Aliceyutzfly/ProjectX_selfbalancing_2627/Hardware/ProjectX_SelfBalance_PCB/ProjectX_SelfBalance.kicad_pcb

## KiCad design hardware/1151-boards/1151-boards.kicad_sch

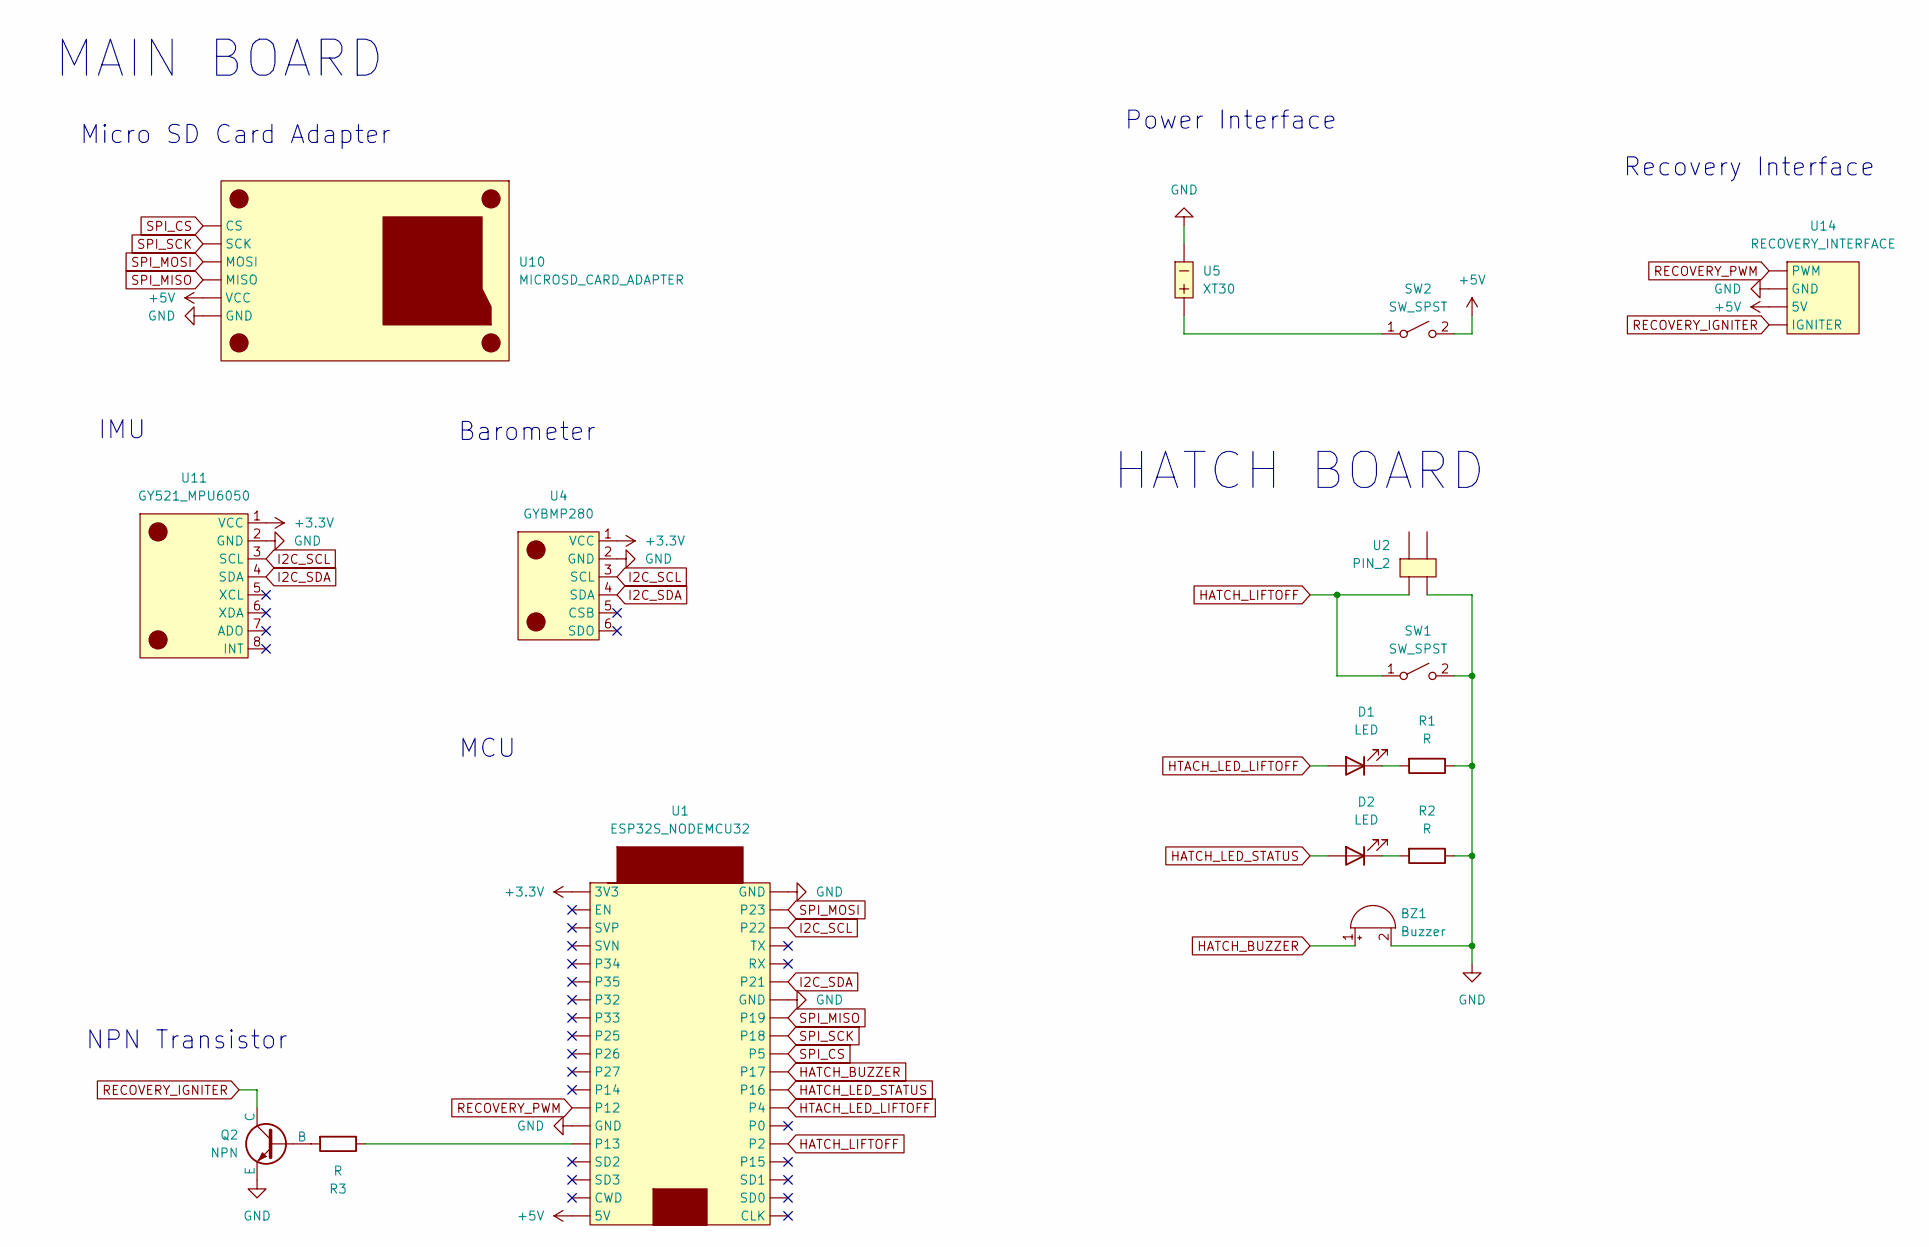
[picture p1: schematic 1151-boards.kicad_sch]

Parts:
BZ1: Buzzer
D1, D2: LED
Q2: NPN
R1, R2, R3: R
SW1, SW2: SW_SPST
U1: ESP32S_NODEMCU32
U2: PIN_2
U4: GYBMP280
U5: XT30
U10: MICROSD_CARD_ADAPTER
U11: GY521_MPU6050
U14: RECOVERY_INTERFACE

Connections:
+3.3V: U1.1 (3V3), U4.1 (VCC), U11.1 (VCC)
+5V: SW2.2 (B), U1.19 (5V), U10., U14.
GND: BZ1.2 (-), Q2.3 (E), R1.1, R2.1, SW1.2 (B), U1.14 (GND), U1.20 (GND), U1.26 (GND), U2., U4.2 (GND), U5., U10., U11.2 (GND), U14.
HATCH_BUZZER: BZ1.1 (+), U1.30 (P17)
HATCH_LED_STATUS: D2.2 (A), U1.31 (P16)
HATCH_LIFTOFF: SW1.1 (A), U1.34 (P2), U2.
HTACH_LED_LIFTOFF: D1.2 (A), U1.32 (P4)
I2C_SCL: U1.22, U4.3 (SCL), U11.3 (SCL)
I2C_SDA: U1.25 (P21), U4.4 (SDA), U11.4 (SDA)
unnamed: D1.1 (K), R1.2
unnamed: D2.1 (K), R2.2
unnamed: Q2.2 (B), R3.2
unnamed: R3.1, U1.15 (P13)
unnamed: SW2.1 (A), U5.
RECOVERY_IGNITER: Q2.1 (C), U14.
RECOVERY_PWM: U1.13 (P12), U14.
SPI_CS: U1.29 (P5), U10.
SPI_MISO: U1.27 (P19), U10.
SPI_MOSI: U1.21 (P23), U10.
SPI_SCK: U1.28 (P18), U10.

Notes on the sheet:
Barometer
Micro SD Card Adapter
Power Interface
MAIN BOARD
NPN Transistor
Recovery Interface
HATCH BOARD
IMU
MCU
