Aliceyutzfly/ProjectX_selfbalancing_2627/Hardware/ProjectX_SelfBalance_PCB/ProjectX_SelfBalance.kicad_pcb

## KiCad design hardware/example/example.kicad_sch

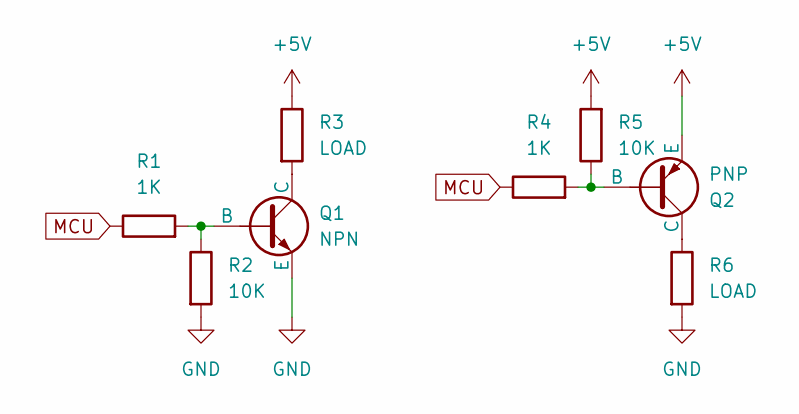
[picture p2: schematic example.kicad_sch]

Parts:
Q1: NPN
Q2: PNP
R1, R4: 1K
R2, R5: 10K
R3, R6: LOAD

Connections:
+5V: Q2.3 (E), R3.1, R5.2
GND: Q1.3 (E), R2.2, R6.2
MCU: R1.1, R4.1
unnamed: Q1.1 (C), R3.2
unnamed: Q1.2 (B), R1.2, R2.1
unnamed: Q2.1 (C), R6.1
unnamed: Q2.2 (B), R4.2, R5.1
