Aliceyutzfly/ProjectX_selfbalancing_2627/(commit log)

2026-10-23 First working commit with 2 modes, manual and avoid obstacles
    [balance.cpp, balance.h, main.cpp, robot_config.h]
2026-10-23 Untouch the platformio, created arduino ide version, test needs to be done
2026-10-27 Code cleaned up with 150 pwm output deadzone and arduino IDE updated version
2026-10-27 Cleaned up Arduino file with fixed deadzone control
    [Balance.ino, Robot_ArduinoIDE.ino, balance.h, robot_config.h]
2026-10-27 Added distance callibration for Arduino IDE code
    [ProjectX_SelfBalance.kicad_pcb, ProjectX_SelfBalance.kicad_sch]
